IHyperspaceI/RGB-Earring/.step

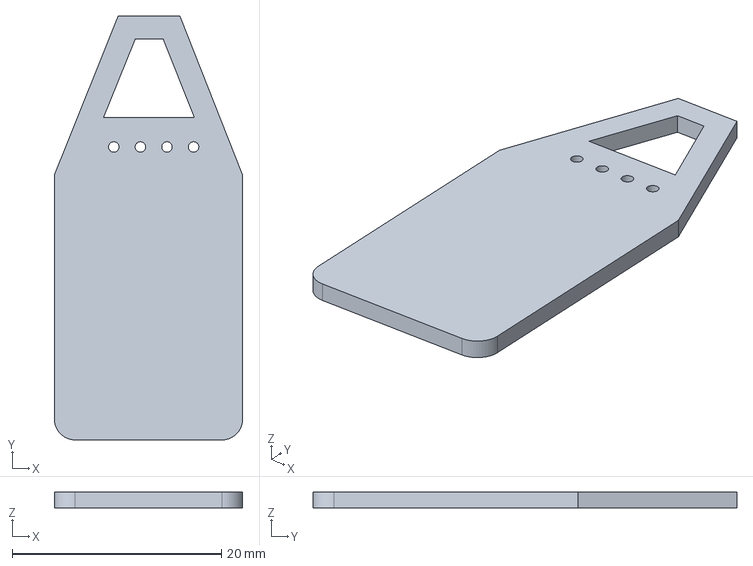
[picture p4: CAD file, 2026-10-12]
.step
18.0 x 40.5 x 1.51 mm
