IHyperspaceI/RGB-Earring/Photos/Schematic.pdf

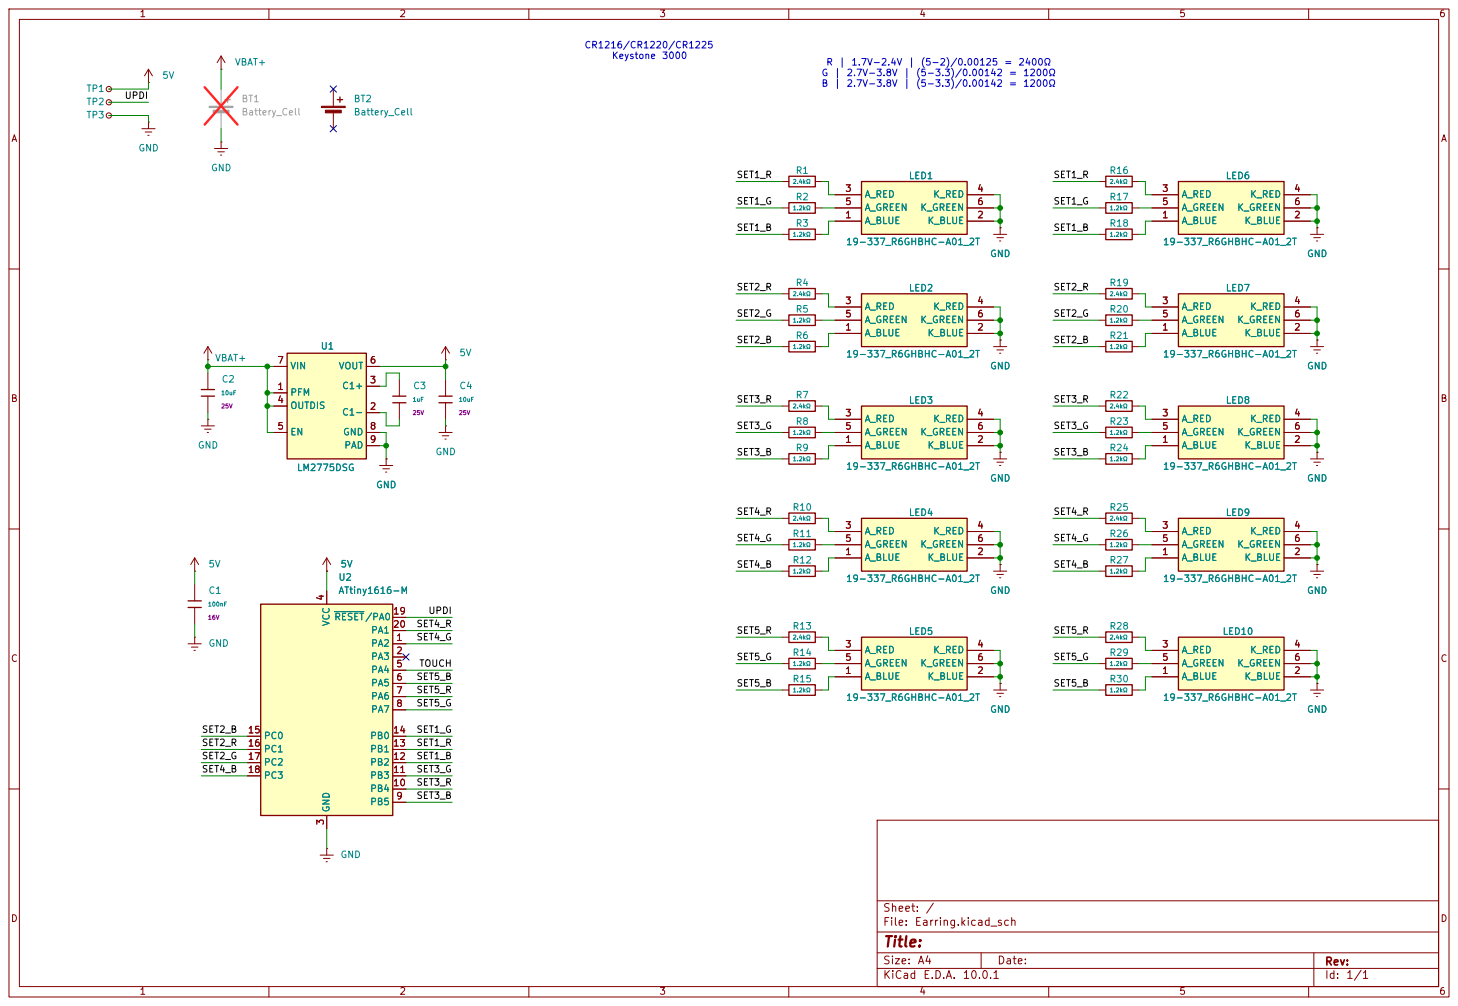
[picture p5: page 1]

Size: A4 | Rev:
KiCad E.D.A. 10.0.1 | Id: 1/1
