IHyperspaceI/RGB-Earring/Earring.kicad_pcb

## KiCad design Earring.kicad_pcb (2026-10-12)

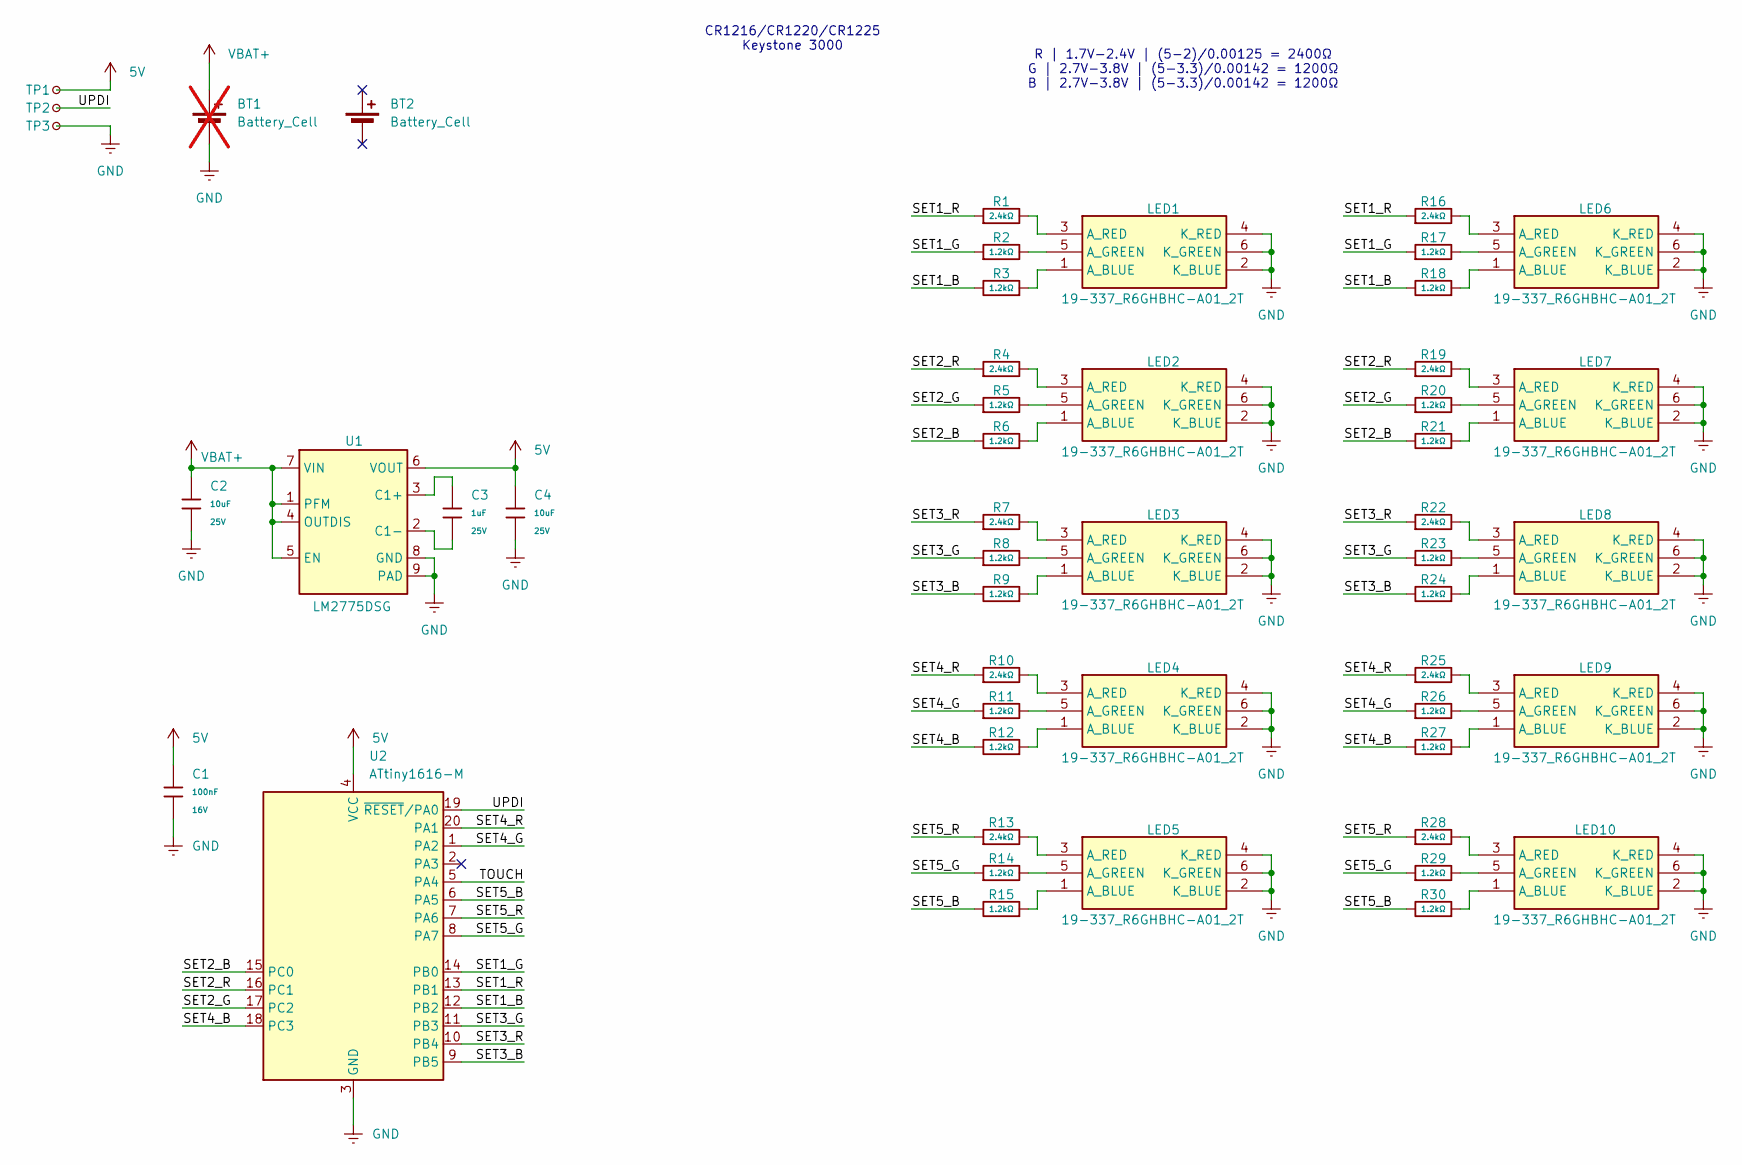
[picture p6: schematic Earring.kicad_sch]

Parts:
BT1: Battery_Cell; BatteryHolder_Keystone_3000_1x12mm; not fitted
BT2: Battery_Cell; BatteryHolder_Keystone_3000_1x12mm
C1: 100nF; C_0402; Voltage Rated 16V; Tolerance ±10%; Part CL05B104KO5NNNC; LCSC C1525
C2, C4: 10uF; C_0603; Voltage Rated 25V; Tolerance ±20%; Part CL10A106MA8NRNC; LCSC C96446
C3: 1uF; C_0402; Voltage Rated 25V; Tolerance ±10%; Part CL05A105KA5NQNC; LCSC C52923
LED1, LED2, LED3, LED4, LED5, LED6, LED7, LED8, LED9, LED10: 19-337_R6GHBHC-A01_2T; Mouser Part Number 638-19337R6GHBHCA01T
R1, R4, R7, R10, R13, R16, R19, R22, R25, R28: 2.4kΩ; R_0402; Overload Voltage (Max) 50V; Tolerance ±1%; Part 0402WGF2401TCE; LCSC C25882
R2, R3, R5, R6, R8, R9, R11, R12, R14, R15, R17, R18, R20, R21, R23, R24, R26, R27, R29, R30: 1.2kΩ; R_0402; Overload Voltage (Max) 50V; Tolerance ±1%; Part 0402WGF1201TCE; LCSC C25862
TP1, TP2: TestPoint_Small; TestPoint_Pad_D1.5mm
TP3: TestPoint_Small; TestPoint_Loop_D2.60mm_Drill0.9mm_Beaded
U1: LM2775DSG; WSON-8-1EP_2x2mm_P0.5mm_EP0.9x1.6mm_ThermalVias
U2: ATtiny1616-M; VQFN-20-1EP_3x3mm_P0.4mm_EP1.7x1.7mm

Connections:
5V: C1.1, C4.1, TP1.1 (1_1), U1.6 (VOUT), U2.4 (VCC)
/SET1_B: R3.2, R18.2, U2.12 (PB2)
/SET1_G: R2.1, R17.1, U2.14 (PB0)
/SET1_R: R1.1, R16.1, U2.13 (PB1)
/SET2_B: R6.2, R21.2, U2.15 (PC0)
/SET2_G: R5.1, R20.1, U2.17 (PC2)
/SET2_R: R4.1, R19.1, U2.16 (PC1)
/SET3_B: R9.2, R24.2, U2.9 (PB5)
/SET3_G: R8.1, R23.1, U2.11 (PB3)
/SET3_R: R7.1, R22.1, U2.10 (PB4)
/SET4_B: R12.2, R27.2, U2.18 (PC3)
/SET4_G: R11.1, R26.1, U2.1 (PA2)
/SET4_R: R10.1, R25.1, U2.20 (PA1)
/SET5_B: R15.2, R30.2, U2.6 (PA5)
/SET5_G: R14.1, R29.1, U2.8 (PA7)
/SET5_R: R13.1, R28.1, U2.7 (PA6)
/TOUCH: U2.5 (PA4)
/UPDI: TP2.1 (1_1), U2.19 (~RESET/PA0)
GND: BT1.2 (-), C1.2, C2.2, C4.2, LED1.2 (K_BLUE), LED1.4 (K_RED), LED1.6 (K_GREEN), LED2.2 (K_BLUE), LED2.4 (K_RED), LED2.6 (K_GREEN), LED3.2 (K_BLUE), LED3.4 (K_RED), LED3.6 (K_GREEN), LED4.2 (K_BLUE), LED4.4 (K_RED), LED4.6 (K_GREEN), LED5.2 (K_BLUE), LED5.4 (K_RED), LED5.6 (K_GREEN), LED6.2 (K_BLUE), LED6.4 (K_RED), LED6.6 (K_GREEN), LED7.2 (K_BLUE), LED7.4 (K_RED), LED7.6 (K_GREEN), LED8.2 (K_BLUE), LED8.4 (K_RED), LED8.6 (K_GREEN), LED9.2 (K_BLUE), LED9.4 (K_RED), LED9.6 (K_GREEN), LED10.2 (K_BLUE), LED10.4 (K_RED), LED10.6 (K_GREEN), TP3.1 (1_1), U1.8 (GND), U1.9 (PAD), U2.3 (GND), U2.21 (GND)
unnamed: LED1.1 (A_BLUE), R3.1
unnamed: LED1.5 (A_GREEN), R2.2
unnamed: LED1.3 (A_RED), R1.2
unnamed: LED2.1 (A_BLUE), R6.1
unnamed: LED2.5 (A_GREEN), R5.2
unnamed: LED2.3 (A_RED), R4.2
unnamed: LED3.1 (A_BLUE), R9.1
unnamed: LED3.5 (A_GREEN), R8.2
unnamed: LED3.3 (A_RED), R7.2
unnamed: LED4.1 (A_BLUE), R12.1
unnamed: LED4.5 (A_GREEN), R11.2
unnamed: LED4.3 (A_RED), R10.2
unnamed: LED5.1 (A_BLUE), R15.1
unnamed: LED5.5 (A_GREEN), R14.2
unnamed: LED5.3 (A_RED), R13.2
unnamed: LED6.1 (A_BLUE), R18.1
unnamed: LED6.5 (A_GREEN), R17.2
unnamed: LED6.3 (A_RED), R16.2
unnamed: LED7.1 (A_BLUE), R21.1
unnamed: LED7.5 (A_GREEN), R20.2
unnamed: LED7.3 (A_RED), R19.2
unnamed: LED8.1 (A_BLUE), R24.1
unnamed: LED8.5 (A_GREEN), R23.2
unnamed: LED8.3 (A_RED), R22.2
unnamed: LED9.1 (A_BLUE), R27.1
unnamed: LED9.5 (A_GREEN), R26.2
unnamed: LED9.3 (A_RED), R25.2
unnamed: LED10.1 (A_BLUE), R30.1
unnamed: LED10.5 (A_GREEN), R29.2
unnamed: LED10.3 (A_RED), R28.2
unnamed: C3.1, U1.3 (C1+)
unnamed: C3.2, U1.2 (C1-)
VBAT+: BT1.1 (+), C2.1, U1.1 (PFM), U1.4 (OUTDIS), U1.5 (EN), U1.7 (VIN)

Notes on the sheet:
R | 1.7V-2.4V | (5-2)/0.00125 = 2400Ω G | 2.7V-3.8V | (5-3.3)/0.00142 = 1200Ω B | 2.7V-3.8V | (5-3.3)/0.00142 = 1200Ω
CR1216/CR1220/CR1225 Keystone 3000

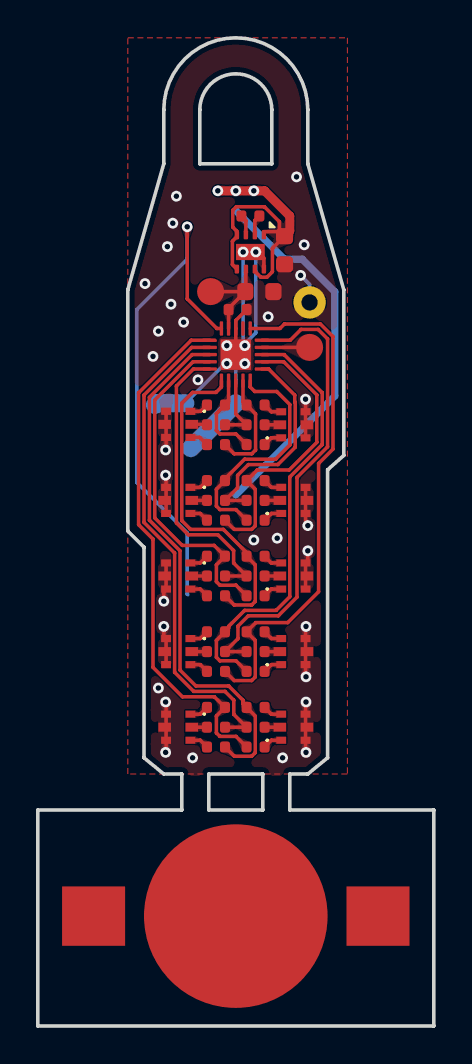
[picture p7: board Earring.kicad_pcb from above]

Board: 2 copper layers, 22.0 x 54.9 mm, 51 parts (1 on the bottom side), 51 nets.
